prabhatbaskota/potato-segregation/README.md

# potato-segregation
This is the final year project carried out by the four students along with me in my bachelors degree.
